avolpone/EE-498---1001/Poster/OCSD-A – Cygnus OA-8 _ Spaceflight101_files/ocsd-6.jpg

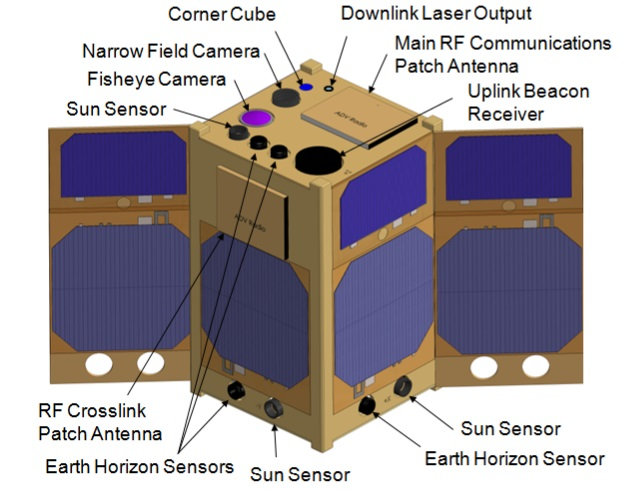
Poster/OCSD-A – Cygnus OA-8 _ Spaceflight101_files/ocsd-6.jpg
