avolpone/EE-498---1001/Poster/OCSD-A – Cygnus OA-8 _ Spaceflight101_files/oa8patch.jpg

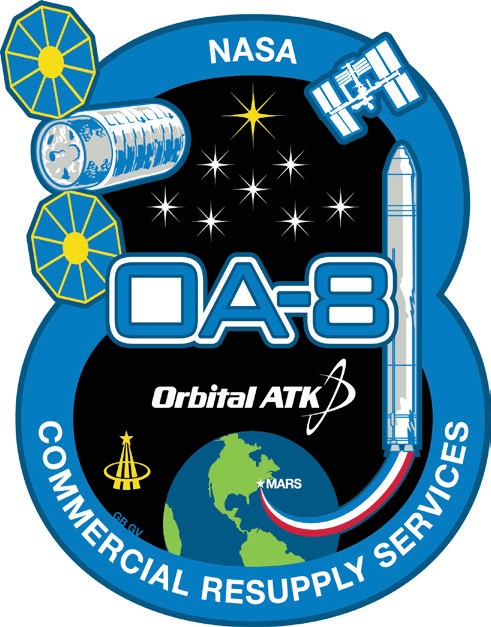
Poster/OCSD-A – Cygnus OA-8 _ Spaceflight101_files/oa8patch.jpg
