avolpone/EE-498---1001/Reports/Flyer.docx

Image result for cubesat

Fiber Optic Sensor for CubeSat

Information Technology Solutions

- Easy to operate
- High Sensitivity
- 3D detection capability
- Impossible to hack
