avolpone/EE-498---1001/Hardware/RenVolpone_Schematic.JPG

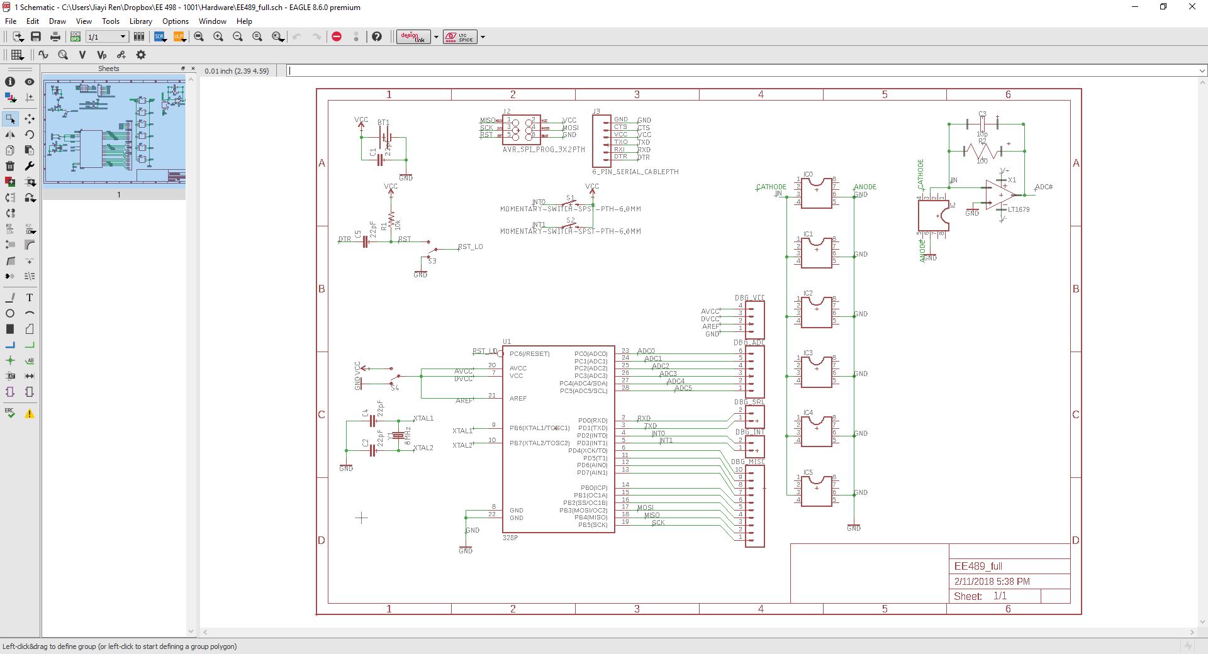
Hardware/RenVolpone_Schematic.JPG
