avolpone/EE-498---1001/Poster/7to1conn.PNG

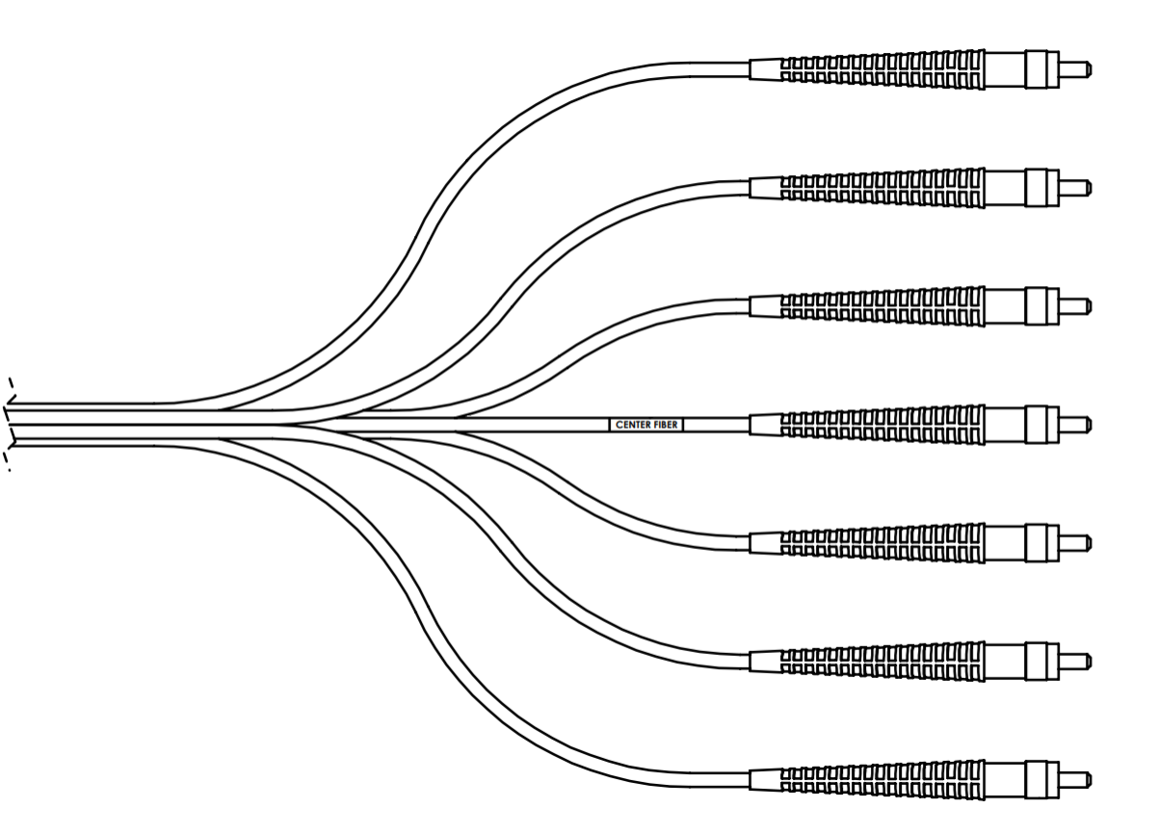
Poster/7to1conn.PNG
