avolpone/EE-498---1001/Poster/7to1core.PNG

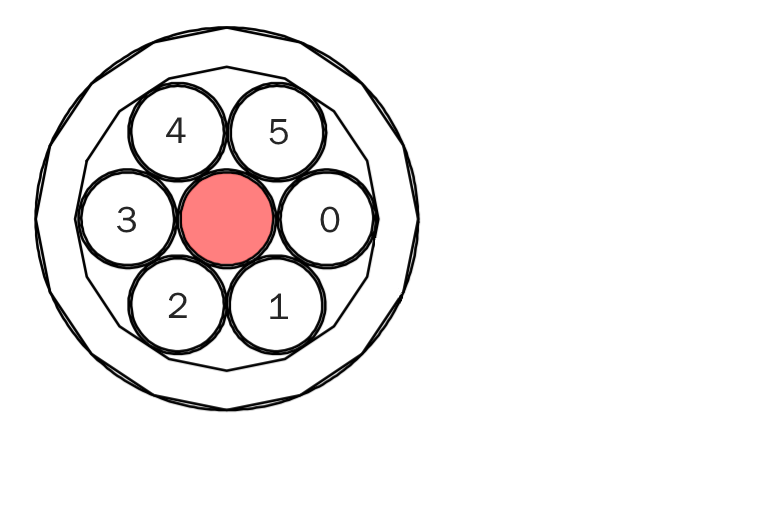
Poster/7to1core.PNG
