avolpone/EE-498---1001/Poster/7to1core_nocolor.png

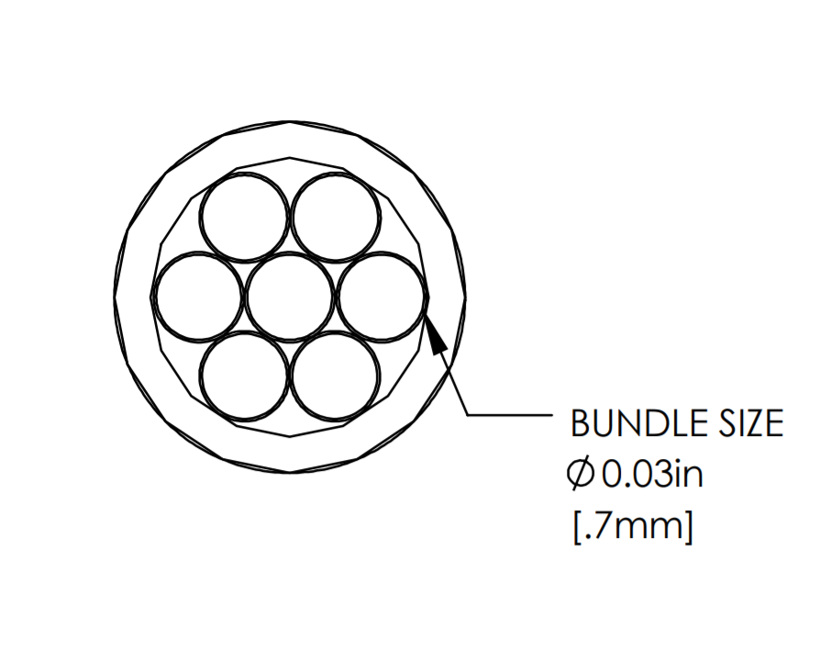
Poster/7to1core_nocolor.png
