avolpone/EE-498---1001/Poster/40507_2016_51_Fig2_HTML.gif

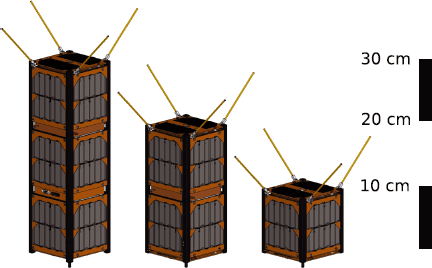
Poster/40507_2016_51_Fig2_HTML.gif
