avolpone/EE-498---1001/Poster/download (1).png

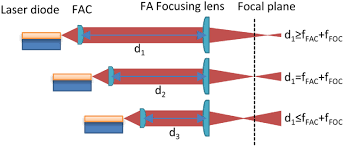
Poster/download (1).png
