avolpone/EE-498---1001/Poster/Fiberport_collimating_780.jpg

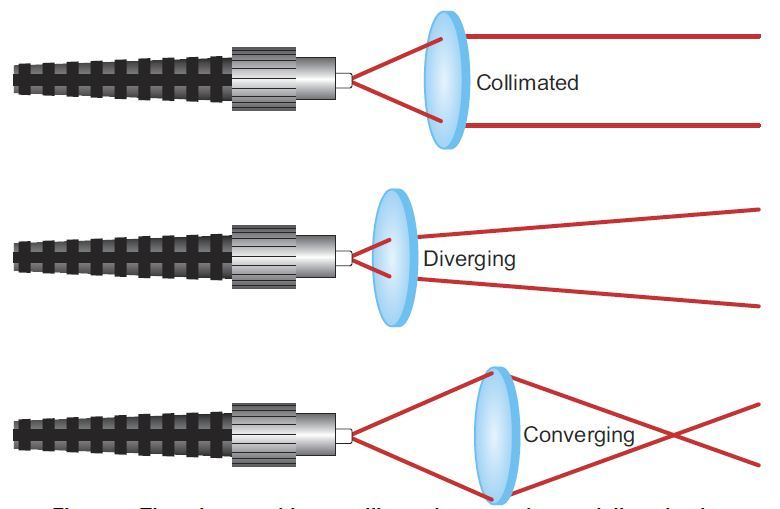
Poster/Fiberport_collimating_780.jpg
