avolpone/EE-498---1001/Poster/horizontal/HowardHughes_Engineering.jpg

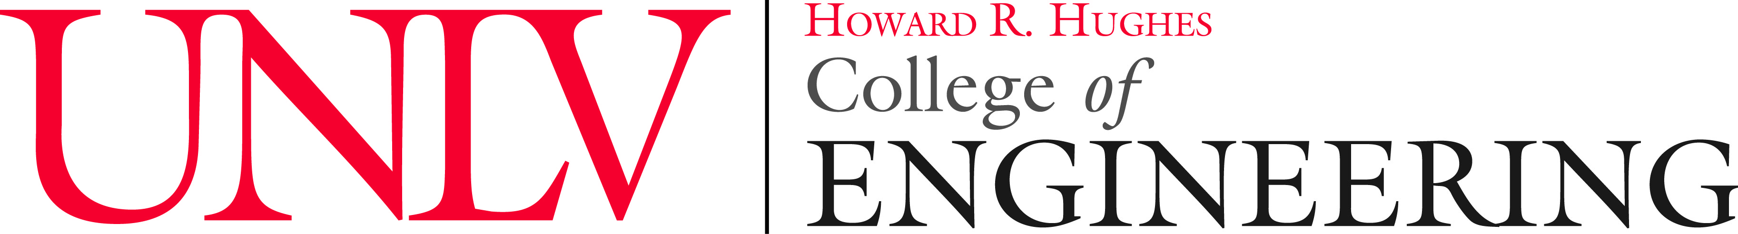
Poster/horizontal/HowardHughes_Engineering.jpg
