avolpone/EE-498---1001/Poster/Laser-symbol.png

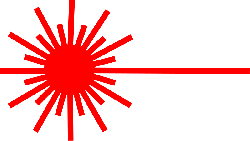
Poster/Laser-symbol.png
