avolpone/EE-498---1001/Poster/LD.PNG

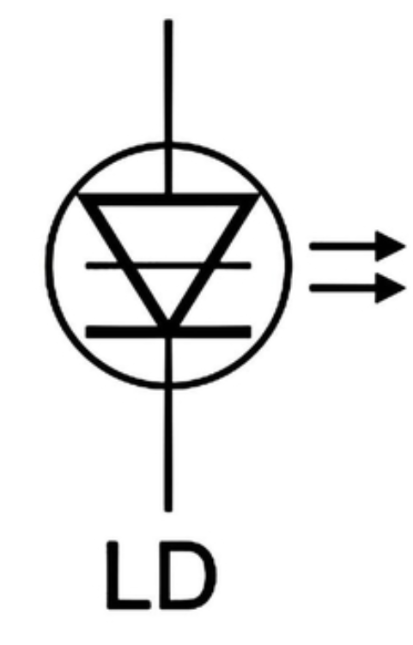
Poster/LD.PNG
