avolpone/EE-498---1001/Poster/OCSD-A – Cygnus OA-8 _ Spaceflight101_files/53t2459pb-1.jpg

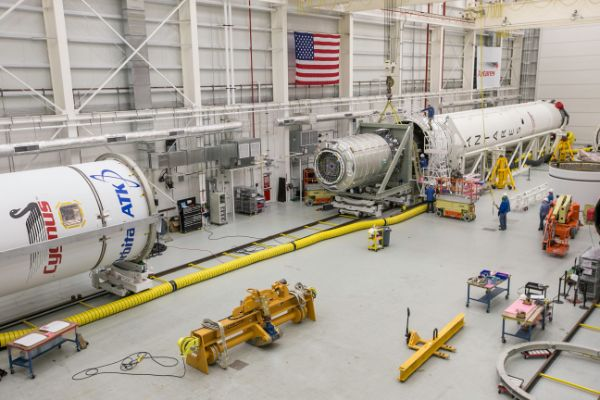
Poster/OCSD-A – Cygnus OA-8 _ Spaceflight101_files/53t2459pb-1.jpg
