avolpone/EE-498---1001/Poster/OCSD-A – Cygnus OA-8 _ Spaceflight101_files/ocsd-4-512x233.jpg

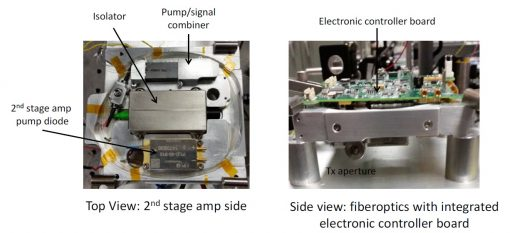
Poster/OCSD-A – Cygnus OA-8 _ Spaceflight101_files/ocsd-4-512x233.jpg
