avolpone/EE-498---1001/Poster/OCSD-A – Cygnus OA-8 _ Spaceflight101_files/sstp_ocsd_illustration-459x512.png

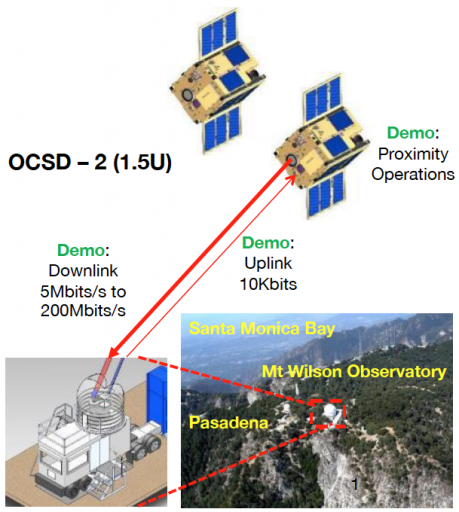
Poster/OCSD-A – Cygnus OA-8 _ Spaceflight101_files/sstp_ocsd_illustration-459x512.png
