avolpone/EE-498---1001/Poster/OCSD-A – Cygnus OA-8 _ Spaceflight101_files/sstp_ocsd_model_acd15-0059-006_15apr15-512x410.jpg

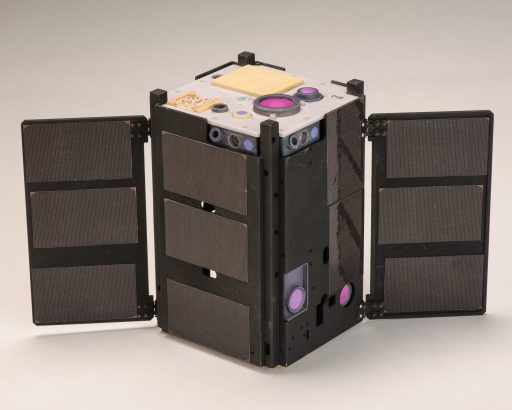
Poster/OCSD-A – Cygnus OA-8 _ Spaceflight101_files/sstp_ocsd_model_acd15-0059-006_15apr15-512x410.jpg
