avolpone/EE-498---1001/Poster/OCSD-A – Cygnus OA-8 _ Spaceflight101_files/stmd_ocsd_1-512x340.jpg

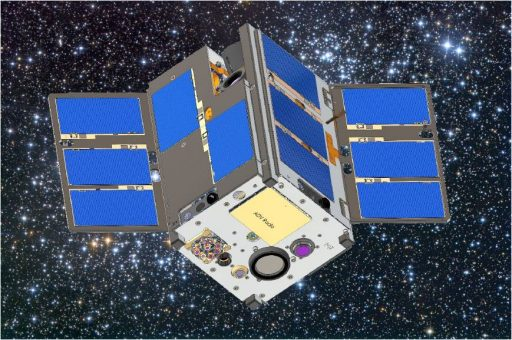
Poster/OCSD-A – Cygnus OA-8 _ Spaceflight101_files/stmd_ocsd_1-512x340.jpg
