avolpone/EE-498---1001/Poster/OCSD-A – Cygnus OA-8 _ Spaceflight101_files/stmd_ocsd_4-512x285.png

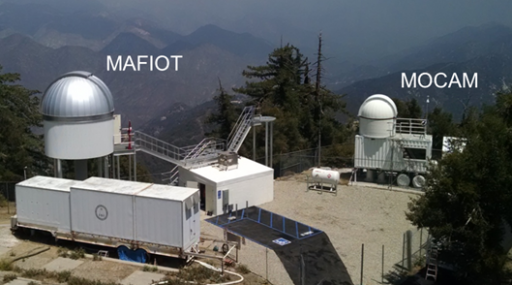
Poster/OCSD-A – Cygnus OA-8 _ Spaceflight101_files/stmd_ocsd_4-512x285.png
