avolpone/EE-498---1001/Poster/Photodiode_symbol.svg.png

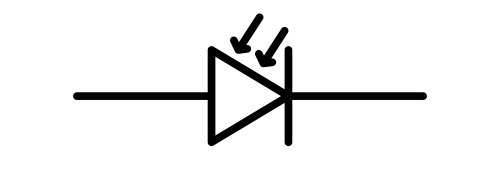
Poster/Photodiode_symbol.svg.png
