avolpone/EE-498---1001/Reports/download.jpg

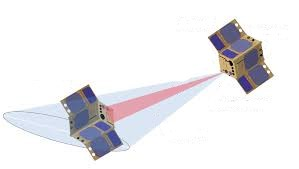
Reports/download.jpg
