avolpone/EE-498---1001/Reports/software sreenshot.PNG

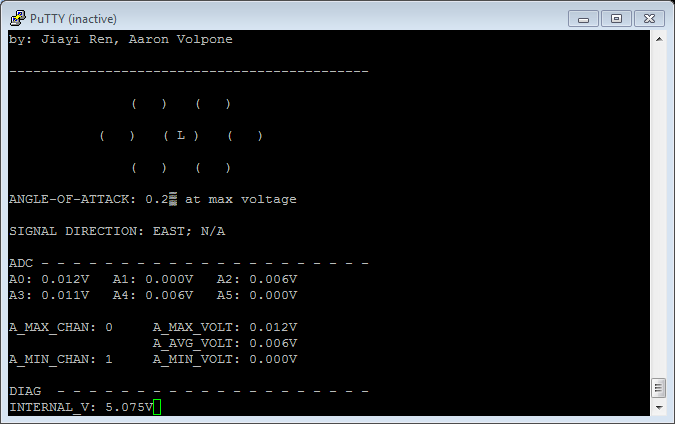
Reports/software sreenshot.PNG
