avolpone/EE-498---1001/Reports/partlist_RenVolpone_FiberOpticSensorCubeSat.docx

Class: | EE498 Senior Design II | | | Semester: | Spring 2018
Group members: | | Project topic: | Fiber Optic Sensor for CubeSat
Jiayi Ren Aaron Volpone
| | Document: | Major components list

Part type | Vendor | Model | Parameters | Picture | Att. id.

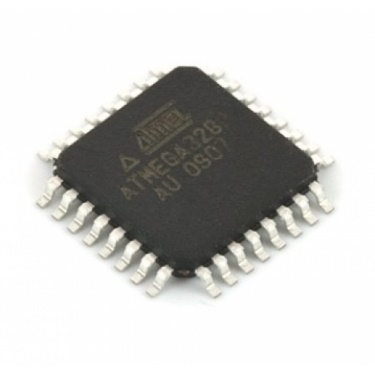
[picture p104: figure]

Microcontroller | Atmel | ATMega328P | Analog Signal Processor | | See reference link[1]


Laser emitter | QPhotonics | QDFBLD-1550-2EM | Light source | | See reference link[2]

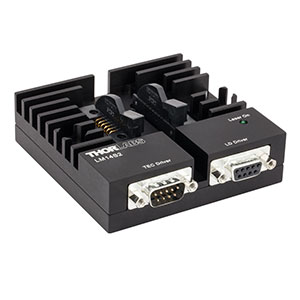
[picture p105: figure]

Laser mount | Thorlabs | LM14S2 | Laser butterfly package driver | | See reference link[3]


Photodiodes (x6) | QPhotonics | QPDF-200 | Light input, voltage output | | See reference link[4]
Multichannel fiber cable | Supplied by Dr. Sun | TBD


Ruled reflective diffraction grating | Thorlabs | GR25-0608 | Mounted reflective surface | | See reference link[5]

[1] Microcontroller - http://www.microchip.com/wwwproducts/ATmega328p

[2] Laser emitter - http://www.qphotonics.com/Wavelength-stabilized-single-mode-fiber-coupled-DFB-laser-diode-2mW-1550nm-QDFBLD-1550-2EM.html Telecom_Datacom_Laser_Modules_Data_Sheet.pdf

[3] Laser mount - https://www.thorlabs.com/thorproduct.cfm?partnumber=LM14S2

[4] Photodiode - http://www.qphotonics.com/Fiber-coupled-InGaAs-PIN-photodiode-QPDF-200.html

[5] Grating mirror - https://www.thorlabs.com/thorproduct.cfm?partnumber=GR25-0608

University of Nevada, Las Vegas
