avolpone/EE-498---1001/Hardware/EE498_full.sch

## EAGLE design Hardware/EE498_full.sch (2018-10-05)

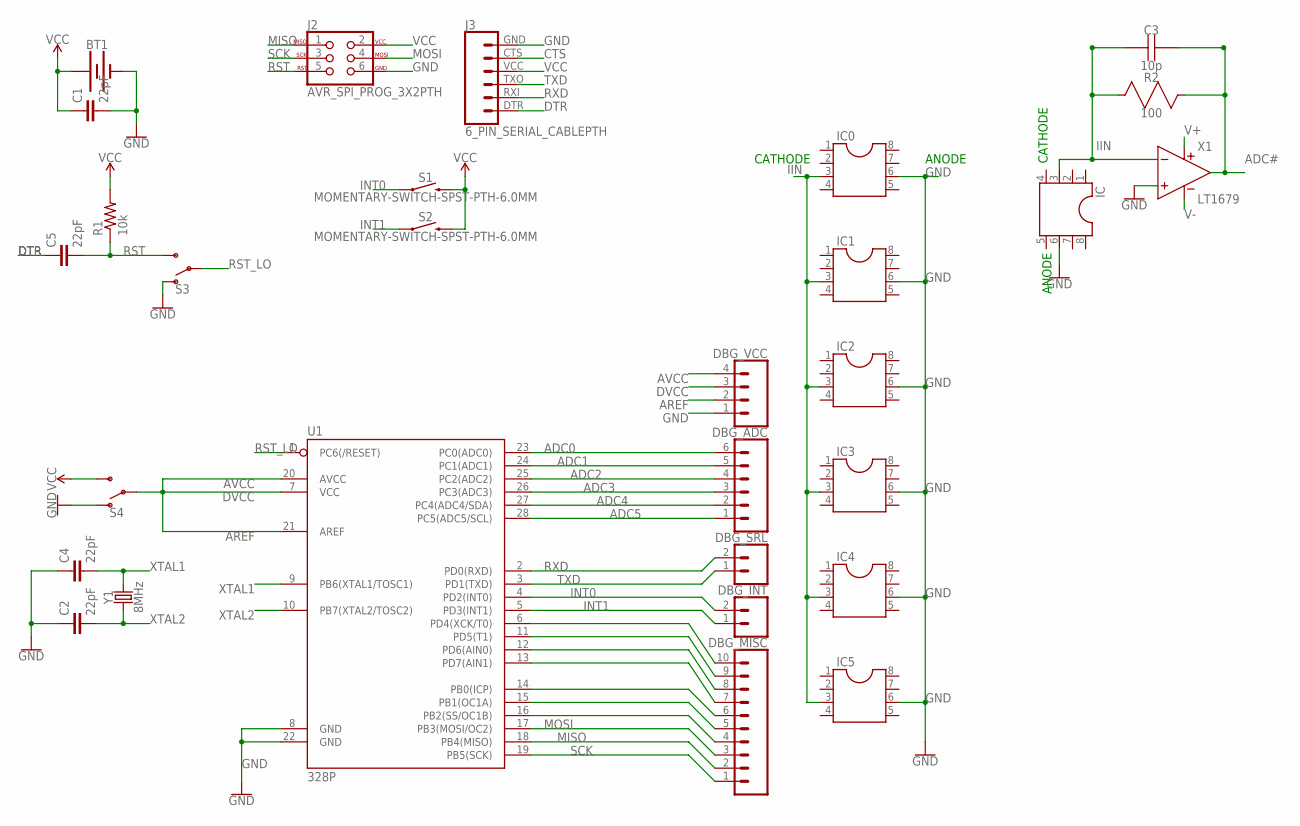
[picture p106: schematic EE498_full.sch]

Parts:
BT1: BATTERY-20MM_SMD_4LEGS; BATTCON_20MM_4LEGS
C1, C2, C4, C5: 22pF; CAP-PTH-2.54
C3: 10p; C0805
DBG_ADC: CONN_06SILK_FEMALE_PTH; 1X06
DBG_INT: CONN_02; 1X02
DBG_MISC: CONN_10"; 1X10
DBG_SRL: CONN_02; 1X02
DBG_VCC: CONN_04; 1X04
IC, IC0, IC1, IC2, IC3, IC4, IC5: DIL8; DIL08
J2: AVR_SPI_PROG_3X2PTH; 2X3
J3: 6_PIN_SERIAL_CABLEPTH; FTDI_BASIC
R1: 10k; 0204/7
R2: 100; R0805
S1, S2: MOMENTARY-SWITCH-SPST-PTH-6.0MM; TACTILE_SWITCH_PTH_6.0MM
S3, S4: SWITCH-SPDT-PTH-11.6X4.0MM; SWITCH_SPDT_PTH_11.6X4.0MM
U1: 328P; DIP28
X1: LT1679
Y1: 8MHz; HC49US

Connections:
ADC0: DBG_ADC.6, U1.23 (PC0(ADC0))
ADC1: DBG_ADC.5, U1.24 (PC1(ADC1))
ADC2: DBG_ADC.4, U1.25 (PC2(ADC2))
ADC3: DBG_ADC.3, U1.26 (PC3(ADC3))
ADC4: DBG_ADC.2, U1.27 (PC4(ADC4/SDA))
ADC5: DBG_ADC.1, U1.28 (PC5(ADC5/SCL))
AREF: DBG_VCC.2
AVCC: DBG_VCC.4
CTS: J3.CTS (5)
DTR: C5.1, J3.DTR (1)
DVCC: DBG_VCC.3
GND: BT1.NEGATIVE (-), C1.2, C2.1, C4.1, DBG_VCC.1, IC.6, J2.6, J3.GND (6), S3.1 (O), S4.1 (O), U1.8 (GND), U1.22 (GND)
IIN: IC0.3, IC1.3, IC2.3, IC3.3, IC4.3, IC5.3, R2.2 (B), X1.P$2 (IN-)
INT0: DBG_INT.2, S1.1, U1.4 (PD2(INT0))
INT1: DBG_INT.1, S2.1, U1.5 (PD3(INT1))
MISO: DBG_MISC.2, J2.1, U1.18 (PB4(MISO))
MOSI: DBG_MISC.3, J2.4, U1.17 (PB3(MOSI/OC2))
unnamed: DBG_MISC.10, U1.6 (PD4(XCK/T0))
unnamed: DBG_MISC.6, U1.14 (PB0(ICP))
unnamed: DBG_MISC.9, U1.11 (PD5(T1))
unnamed: DBG_MISC.8, U1.12 (PD6(AIN0))
unnamed: DBG_MISC.7, U1.13 (PD7(AIN1))
unnamed: DBG_MISC.5, U1.15 (PB1(OC1A))
unnamed: DBG_MISC.4, U1.16 (PB2(SS/OC1B))
unnamed: R2.1 (A), X1.P$1 (OUT)
RST: C5.2, J2.5, R1.1, S3.3 (S)
RST_LO: S3.2, U1.1 (PC6(/RESET))
RXD: DBG_SRL.2, J3.RXI (2), U1.2 (PD0(RXD))
SCK: DBG_MISC.1, J2.3, U1.19 (PB5(SCK))
TXD: DBG_SRL.1, J3.TXO (3), U1.3 (PD1(TXD))
V+: X1.P$4 (VCC)
V-: X1.P$11 (VEE)
VCC: BT1.POSITIVE@1 (+), C1.1, J2.2, J3.VCC (4), R1.2, S1.3 (2), S2.3 (2), S4.3 (S)
VCC_SW: S4.2, U1.7 (VCC), U1.20 (AVCC), U1.21 (AREF)
XTAL1: C4.2, U1.9 (PB6(XTAL1/TOSC1)), Y1.2
XTAL2: C2.2, U1.10 (PB7(XTAL2/TOSC2)), Y1.1

Notes on the sheet:
CATHODE
ANODE
