avolpone/EE-498---1001/Reports/Photo Feb 16, 18 09 23.jpg

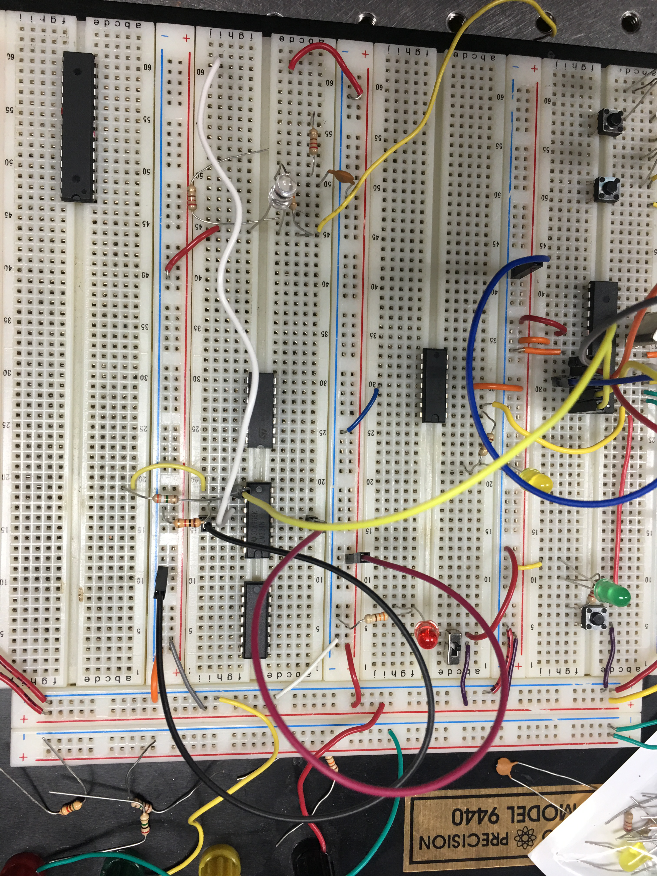
Reports/Photo Feb 16, 18 09 23.jpg
